nightseas/pi_mods/software/ica_test_codes/README.md

# Test codes for ICA HAT

By Xiaohai Li (haixiaolee@gmail.com)

To run these codes you need to install two hardware libs on Pi:

 - wiringPi-Python2 (which may be merged to wiringPi-Python now);
 - pigpio (only use the python part)
