nightseas/pi_mods/hardware/pi_mod_ica/PiModICA_R0A_BOM.xlsx

ICA HAT for Raspberry Pi Revised: Tuesday, May 19, 2015
ICA Revision: R0A
Item | Part | PCB FP | Quantity | Reference
1 | 0.1uF NC | C0603 | 1 | C1
2 | 0.1uF | C0603 | 1 | C2
3 | 10uF | C0805 | 1 | C3
4 | LED_IR | SIP2 | 1 | D1
5 | LED_IR NC | SIP2 | 1 | D2
6 | RPI CON | SIP20X2 | 1 | J1
7 | EXT IO | SIP4 | 1 | J2
8 | EXT IIC | SIP4 | 1 | J3
9 | EXT UART | SIP4 | 1 | J4
10 | EXT SPI | SIP7 | 1 | J5
11 | EXT PWR | SIP4 | 1 | J6
12 | GRN | LED0805 | 4 | LD1,LD2,LD3,LD4
13 | LED_SEG7_X4_DP | LED_SEG7_X4_DP_036 | 2 | LD5,LD6
14 | RED | LED0805 | 1 | LD7
15 | 2N7002_NMOS | SOT23 | 3 | Q1,Q2,Q3
16 | 9013 | SOT23 | 2 | Q4,Q5
17 | 10K NC | R0603 | 2 | R1,R39
18 | 10K | R0603 | 14 | R2,R3,R4,R5,R6,R7,R8,R9,R10,R11,R16,R17,R31,R35
19 | 100R | R0603 | 11 | R12,R13,R20,R21,R23,R24,R27,R28,R29,R30,R32
20 | 510R | R0603 | 6 | R14,R15,R18,R19,R22,R33
21 | 120R | R0603 | 1 | R25
22 | 120R NC | R0603 | 1 | R26
23 | 1K | R0603 | 1 | R34
24 | 0R NC | R0603 | 3 | R36,R37,R38
25 | USER_KEY | SW_6X6_180D | 5 | SW1,SW2,SW3,SW4,SW5
26 | TH2_5 | TH2_5 | 4 | TH1,TH2,TH3,TH4
27 | AT24C02 NC | SO8 | 1 | U1
28 | MAX7219CWG | WSO24 | 1 | U2
29 | BUZZER | BUZZER_12X9_5 | 1 | U3
30 | HS0038 | IR_RECV | 1 | U4
