nightseas/pi_mods/hardware/pi_mod_mot/PiMod_MOT_R0A_SCH.pdf

NC unused GPIO pins and the 3.3V power pins. RPi only needs 5V external supply.

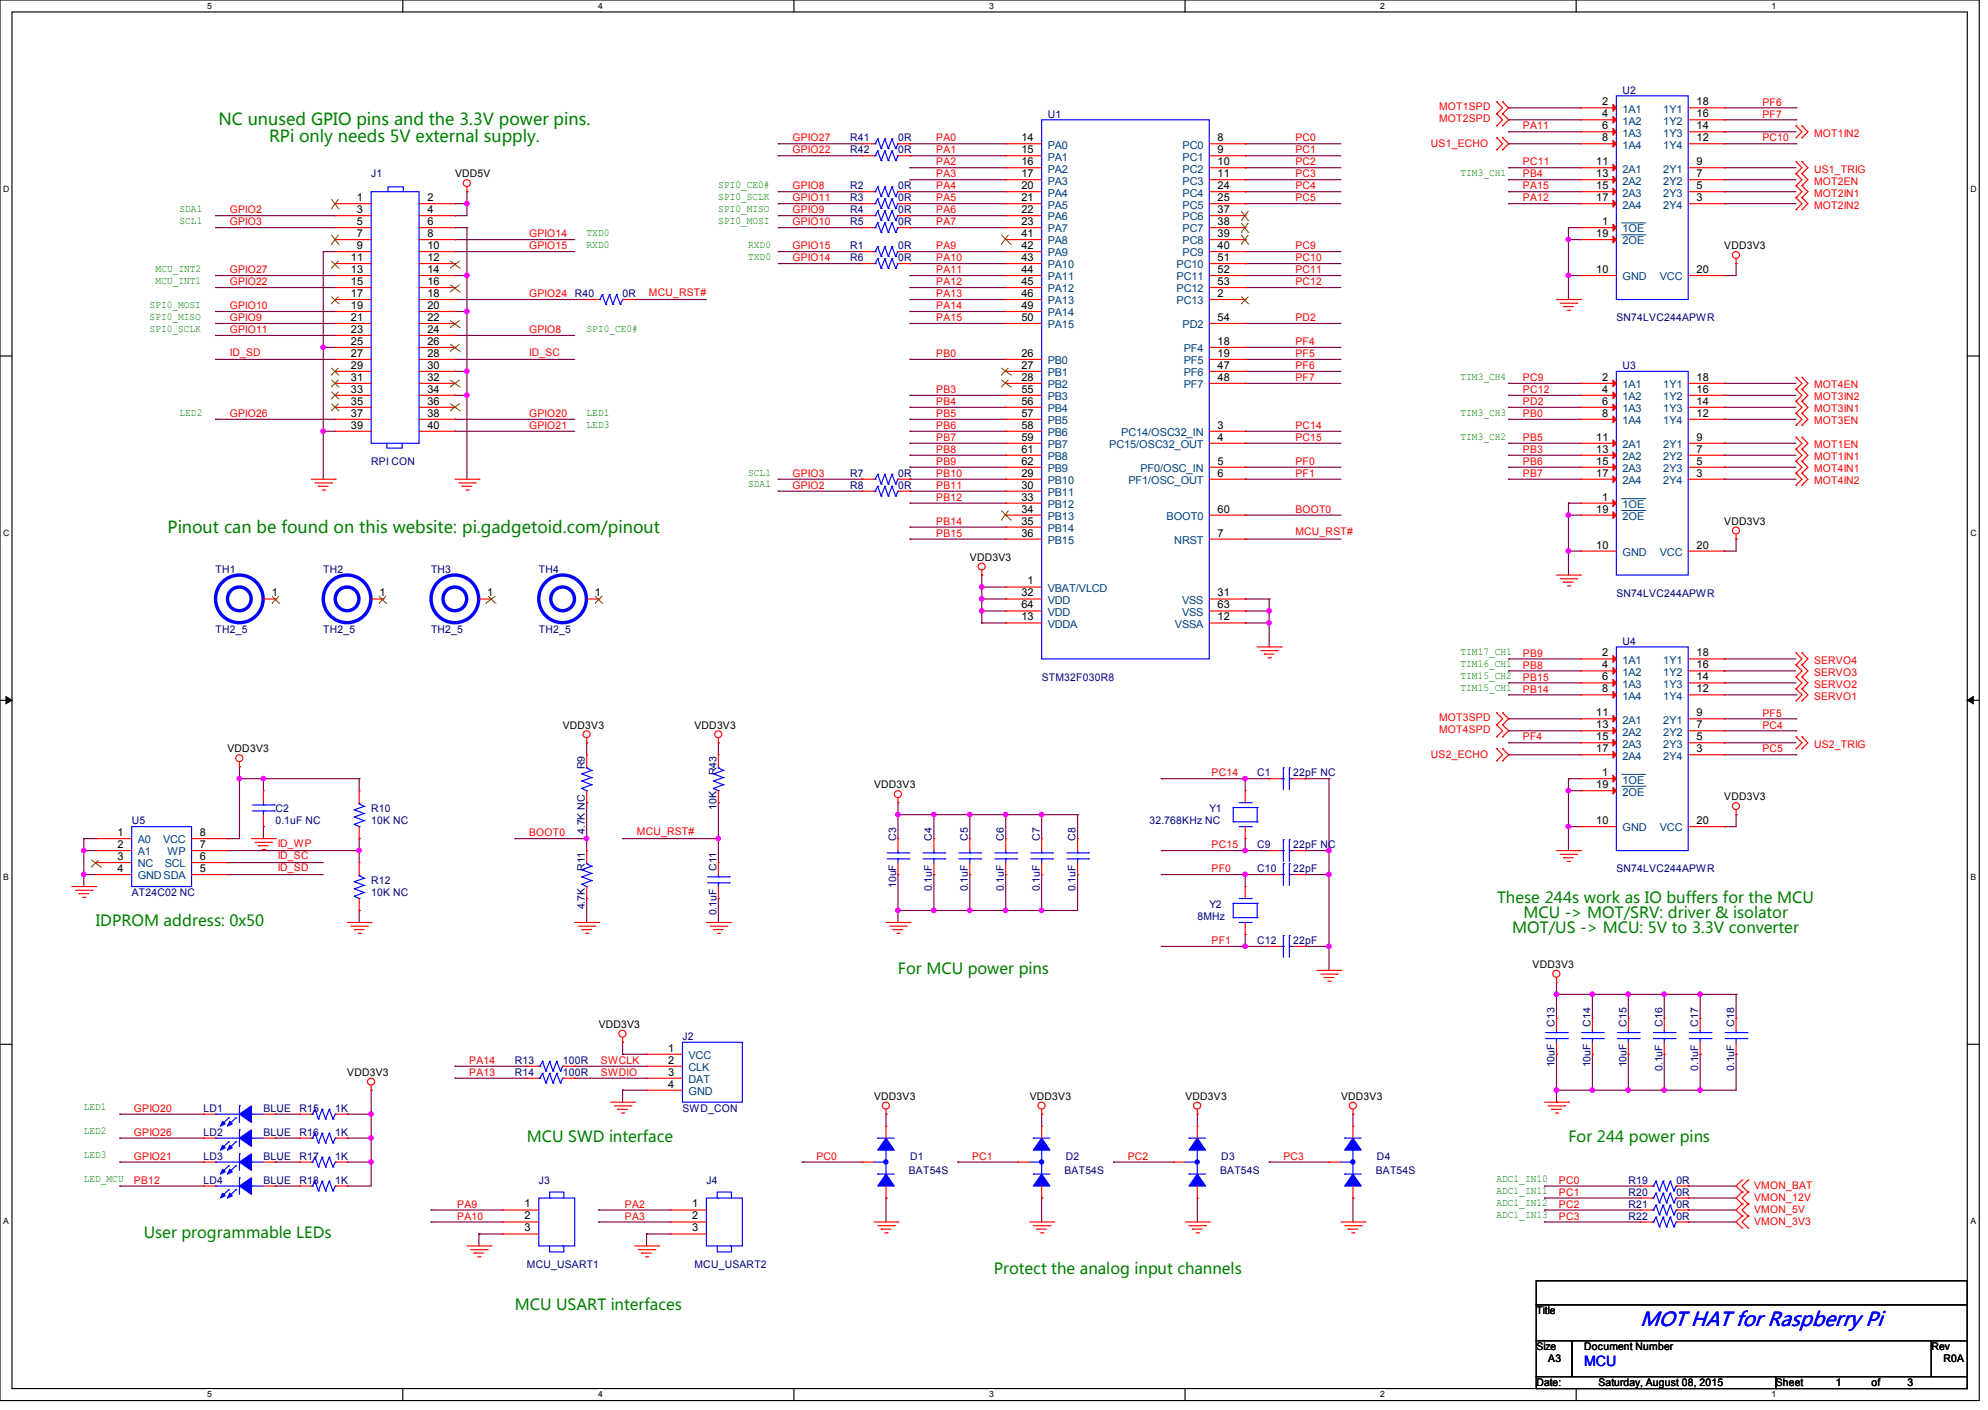
[picture p1: page 1]

Pinout can be found on this website: pi.gadgetoid.com/pinout

These 244s work as IO buffers for the MCU
MCU -> MOT/SRV: driver & isolator
MOT/US -> MCU: 5V to 3.3V converter

For MCU power pins

Protect the analog input channels

MOT HAT for Raspberry Pi

## [DC Geared Motor] Voltage: 3~6V

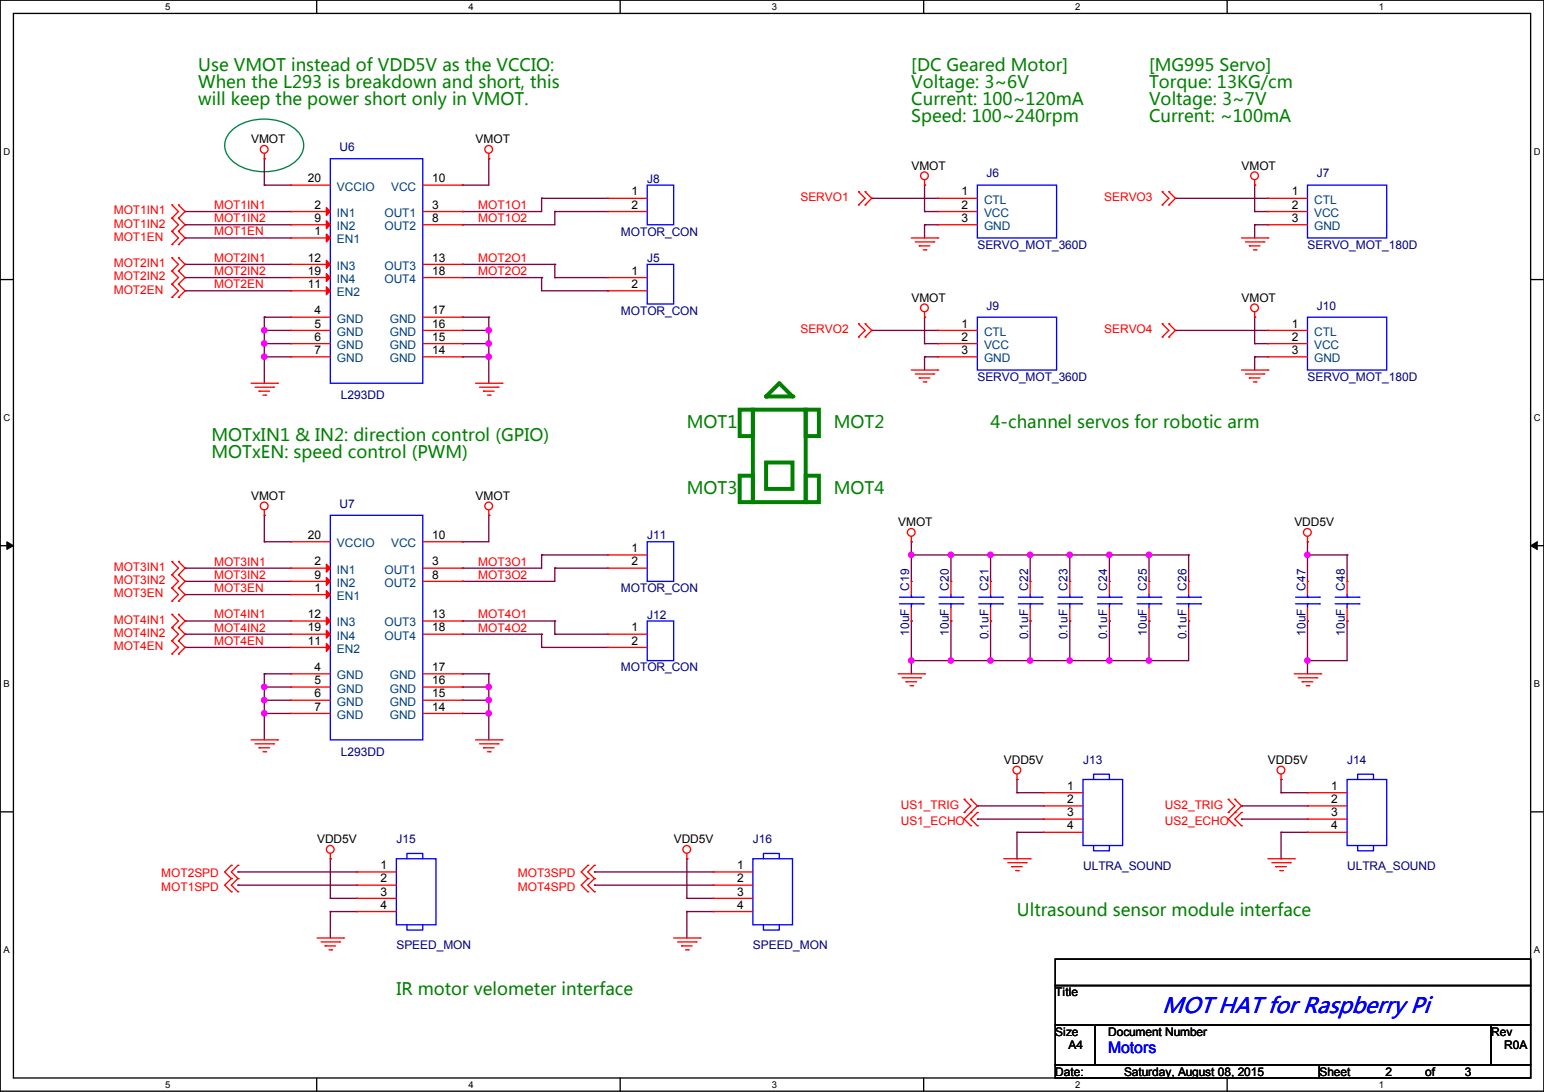
[picture p2: page 2]

Use VMOT instead of VDD5V as the VCCIO:
When the L293 is breakdown and short, this
will keep the power short only in VMOT.

4-channel servos for robotic arm

MOTxIN1 & IN2: direction control (GPIO)
MOTxEN: speed control (PWM)

Ultrasound sensor module interface

IR motor velometer interface

RA

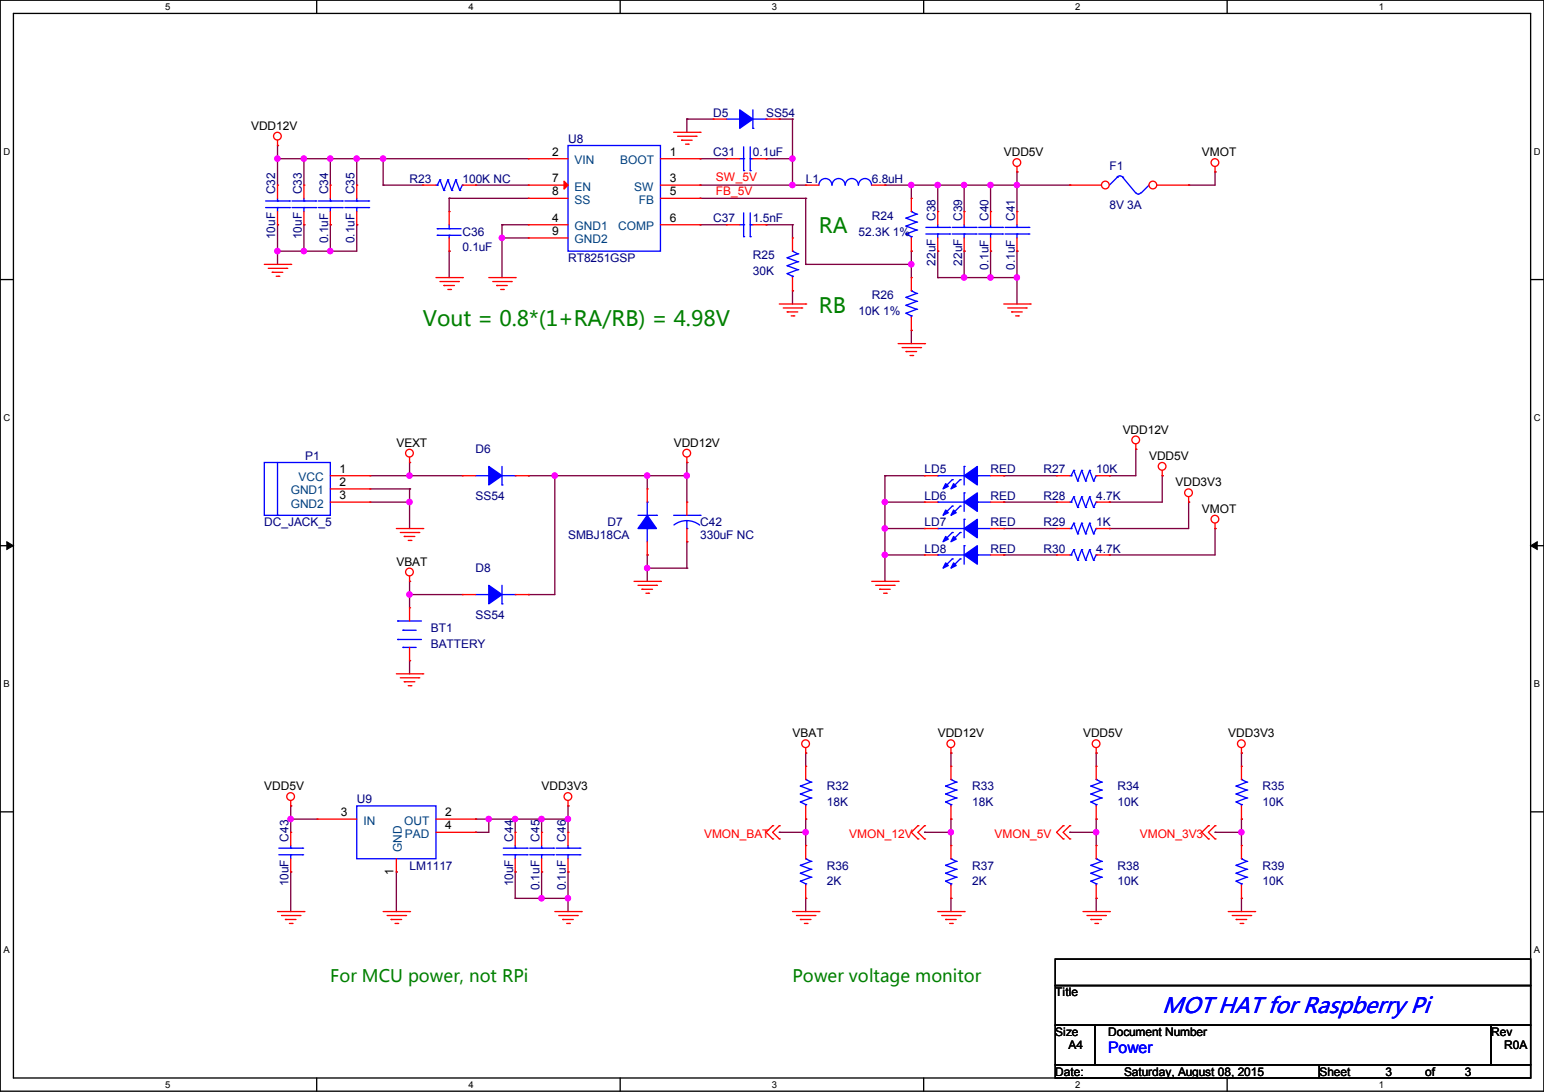
[picture p3: page 3]

RB Vout = 0.8*(1+RA/RB) = 4.98V
