nightseas/pi_mods/hardware/pi_mod_ica/PiMod_ICA_R0A_SCH.pdf

## Segmental LEDs & Serial Driver

## NC PIN1(3.3V) for better layout

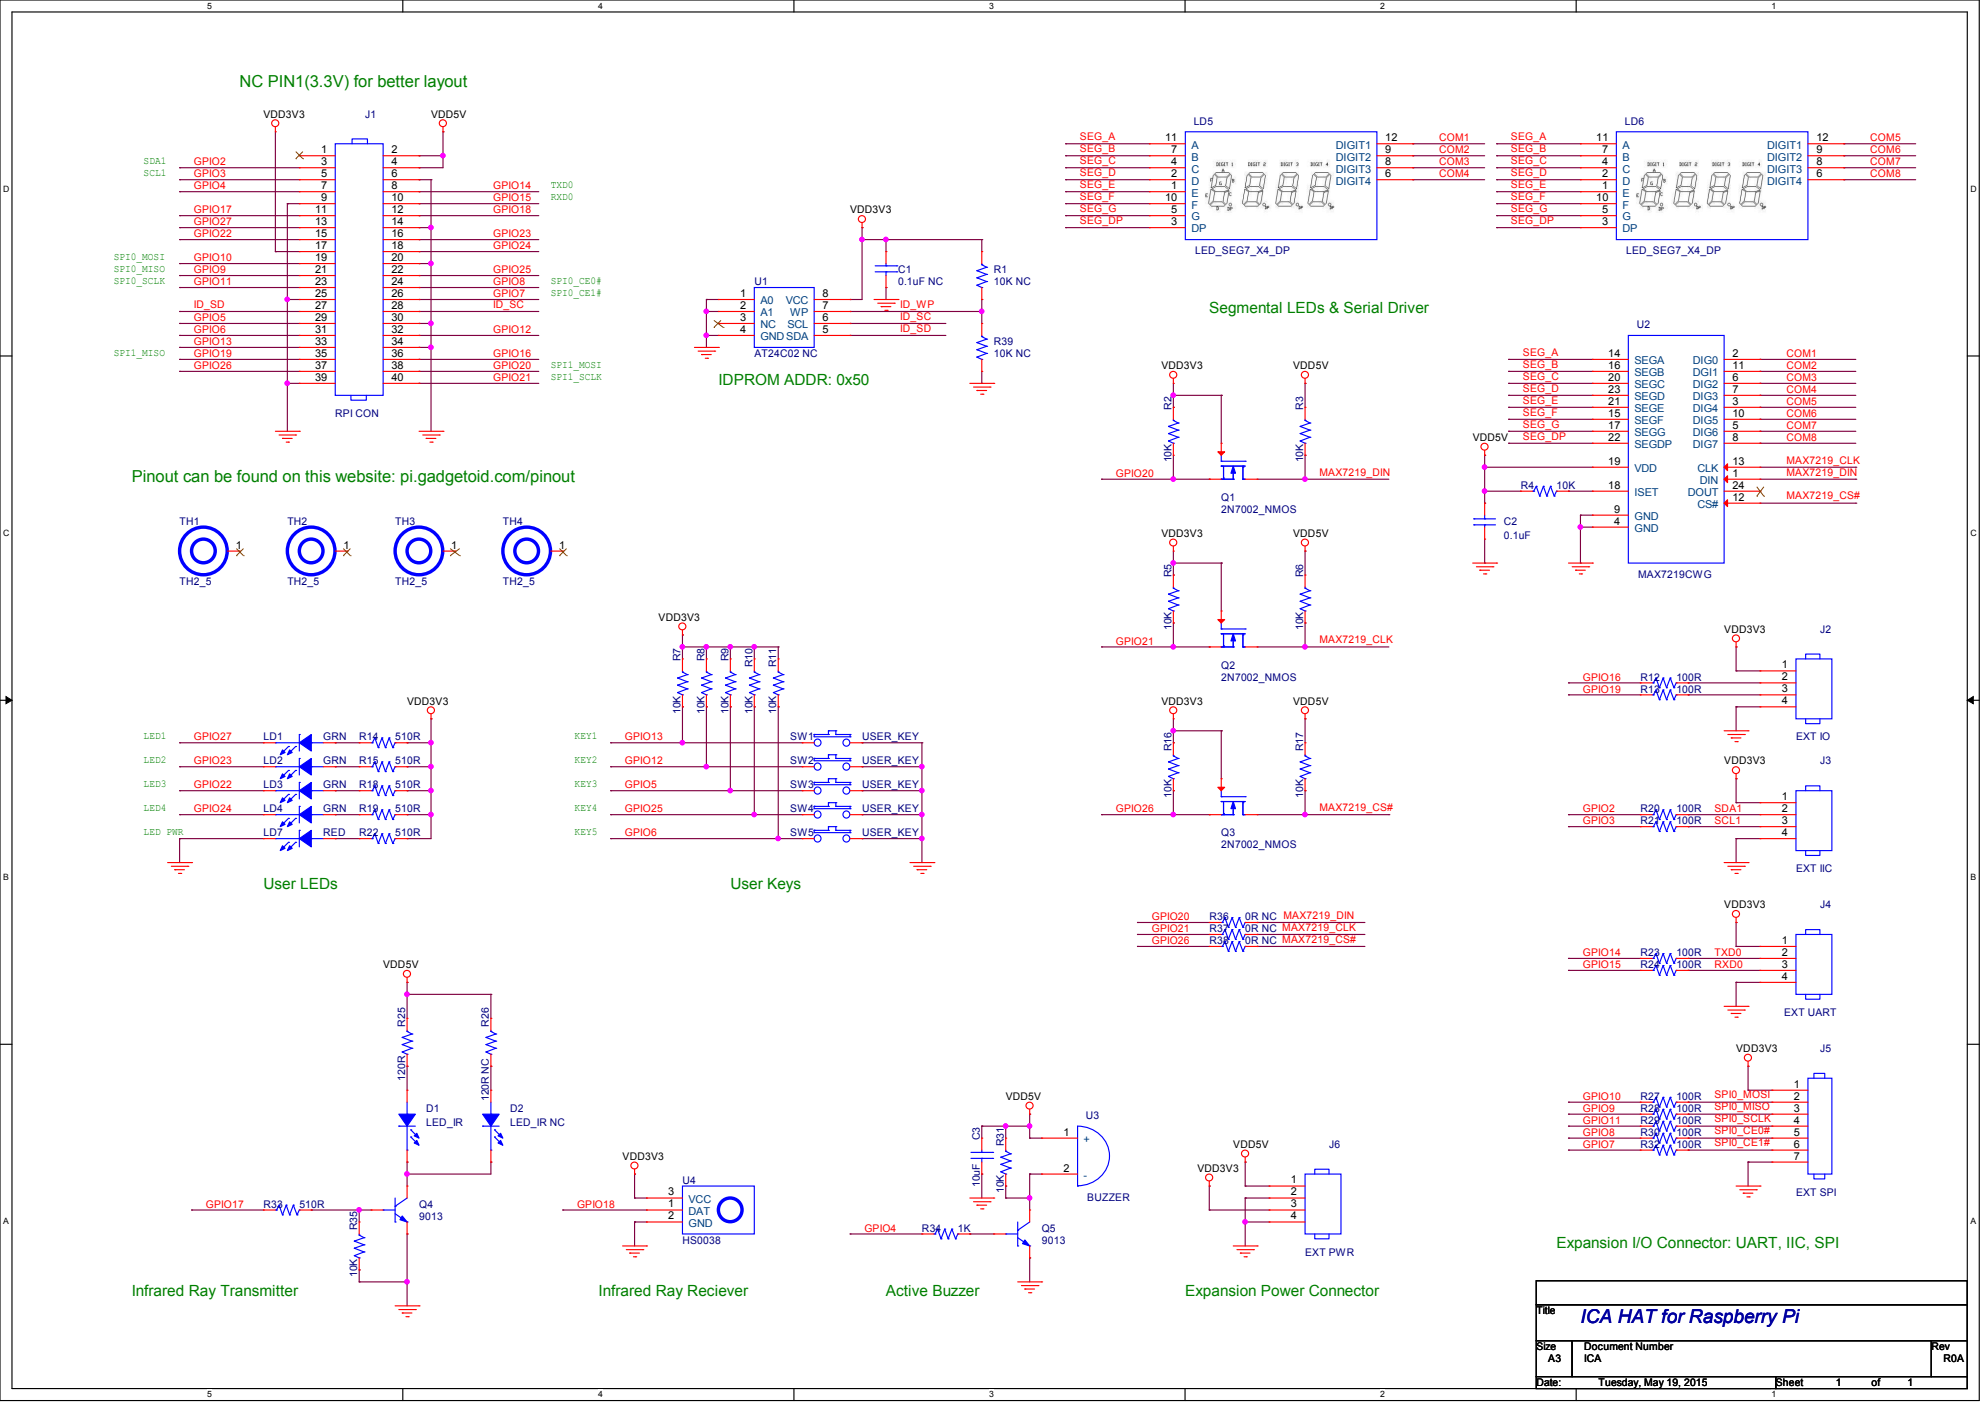
[picture p4: page 1]

Pinout can be found on this website: pi.gadgetoid.com/pinout

Expansion I/O Connector: UART, IIC, SPI

Title
ICA HAT for Raspberry Pi
