nightseas/pi_mods/hardware/pi_mod_ica/PiMod_ICA_R0A_AssemblyBottom.pdf

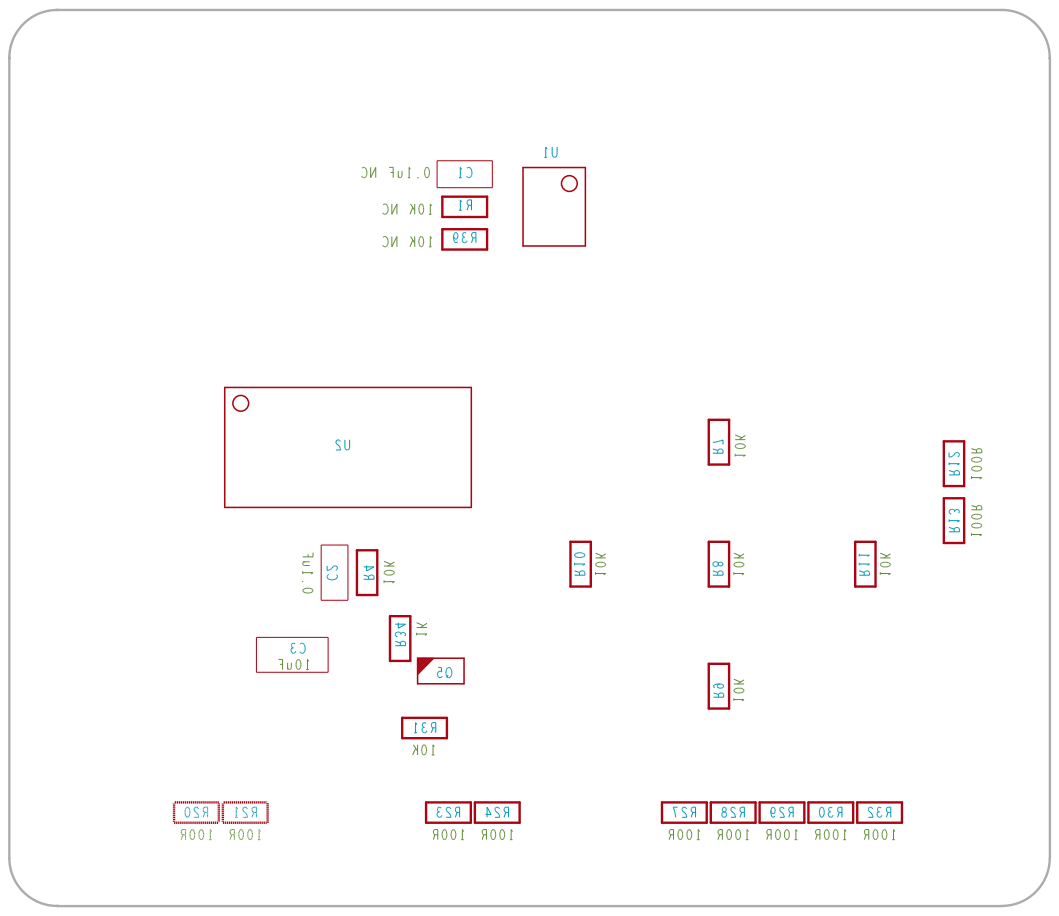
[picture p5: page 1]
