nightseas/pi_mods/hardware/pi_mod_ica/PiMod_ICA_R0A_AssemblyTop.pdf

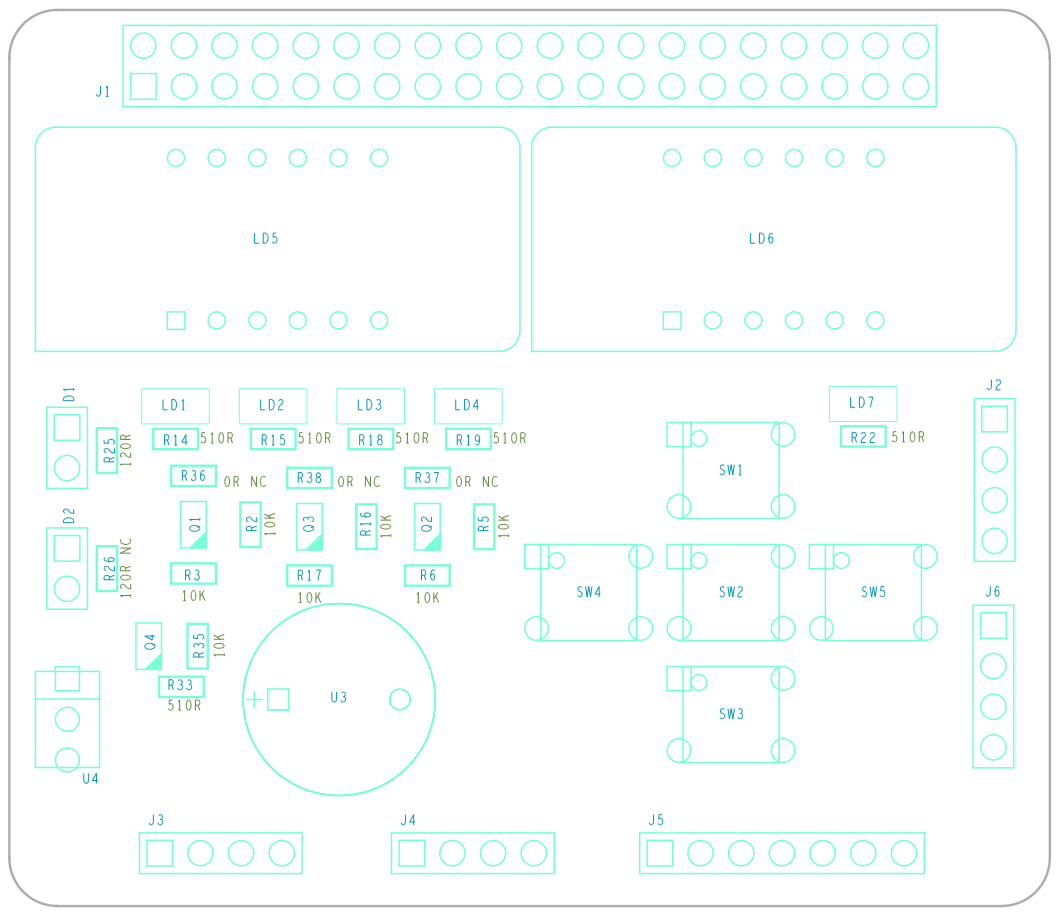
[picture p6: page 1]
