nightseas/pi_mods/hardware/pi_mod_ica/PiMod_ICA_R0A_PCB.pdf

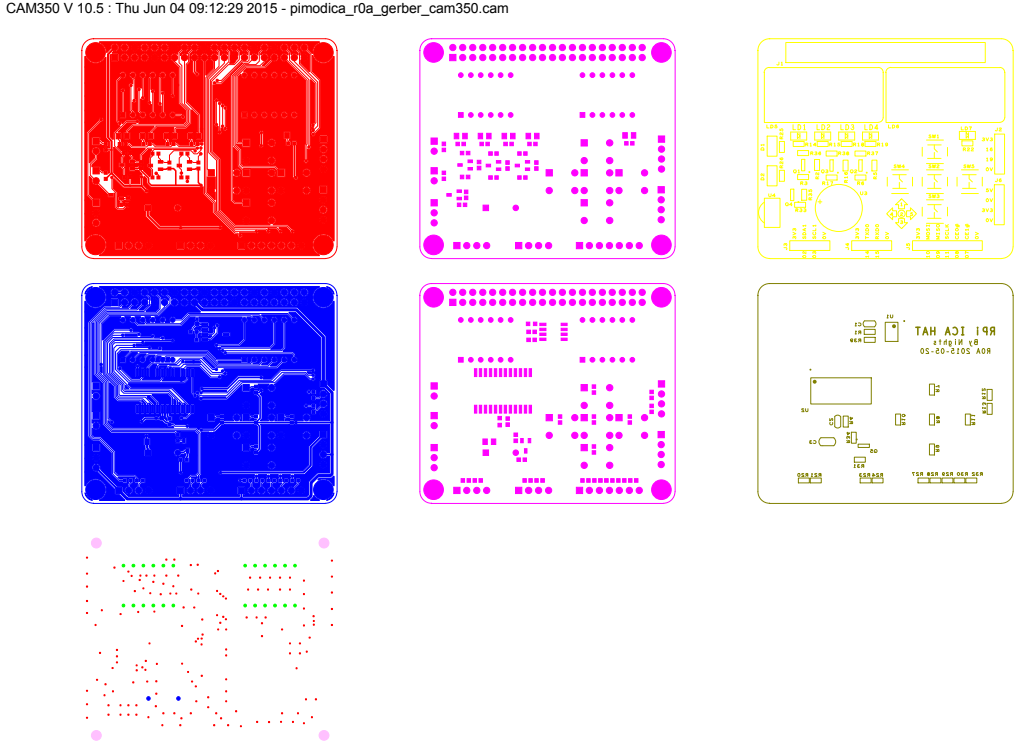
[picture p7: page 1]

CAM350 V 10.5 : Thu Jun 04 09:12:29 2015 - pimodica_r0a_gerber_cam350.cam
