nightseas/pi_mods/(list of files, drawings)

Other design files:
hardware/pi_mod_ica/PiMod_ICA_R0A.DSN
hardware/pi_mod_mot/PiMod_MOT_R0A.DSN
hardware/pi_mod_proto/PiModProto_R0A.DSN
