nightseas/pi_mods/software/ica_test_codes/font_en_8x8.py

# font_en_8x8.py
# Display charactors library for 8x8 LED matrix, just for test.

data = [\
[0x00,0x00,0x00,0x00,0x00,0x00,0x00,0x00],\
[0x00,0x00,0x5F,0x00,0x00,0x00,0x00,0x00],\
[0x00,0x0A,0x06,0x00,0x00,0x0A,0x06,0x00],\
[0x00,0x20,0x74,0x2E,0x74,0x2E,0x04,0x00],\
[0x00,0x24,0x2A,0x7F,0x2A,0x12,0x00,0x00],\
[0x00,0x4E,0x2A,0x1E,0x78,0x54,0x72,0x00],\
[0x00,0x70,0x8E,0xB9,0x56,0xB0,0x80,0x00],\
[0x00,0x00,0x00,0x02,0x00,0x00,0x00,0x00],\
[0x00,0x00,0x1C,0x22,0x41,0x00,0x00,0x00],\
[0x00,0x00,0x41,0x22,0x1C,0x00,0x00,0x00],\
[0x00,0x24,0x18,0x7E,0x18,0x24,0x00,0x00],\
[0x00,0x08,0x08,0x3E,0x08,0x08,0x00,0x00],\
[0x00,0x00,0x40,0x58,0x38,0x00,0x00,0x00],\
[0x00,0x08,0x08,0x08,0x08,0x08,0x08,0x00],\
[0x00,0x60,0x60,0x00,0x00,0x00,0x00,0x00],\
[0x00,0x40,0x20,0x10,0x08,0x04,0x02,0x00],\
[0x00,0x3e,0x51,0x49,0x45,0x3e,0x00,0x00],\
[0x00,0x00,0x42,0x7f,0x40,0x00,0x00,0x00],\
[0x00,0x42,0x61,0x51,0x49,0x46,0x00,0x00],\
[0x00,0x21,0x41,0x45,0x4b,0x31,0x00,0x00],\
[0x00,0x18,0x14,0x12,0x7f,0x10,0x00,0x00],\
[0x00,0x27,0x45,0x45,0x45,0x39,0x00,0x00],\
[0x00,0x3c,0x4a,0x49,0x49,0x30,0x00,0x00],\
[0x00,0x01,0x01,0x79,0x05,0x03,0x00,0x00],\
[0x00,0x36,0x49,0x49,0x49,0x36,0x00,0x00],\
[0x00,0x06,0x49,0x49,0x29,0x1e,0x00,0x00],\
[0x00,0x00,0x66,0x66,0x00,0x00,0x00,0x00],\
[0x00,0x00,0x40,0x32,0x00,0x00,0x00,0x00],\
[0x00,0x08,0x14,0x22,0x41,0x00,0x00,0x00],\
[0x00,0x24,0x24,0x24,0x24,0x24,0x24,0x00],\
[0x00,0x41,0x22,0x14,0x08,0x00,0x00,0x00],\
[0x00,0x06,0x01,0x51,0x09,0x06,0x00,0x00],\
[0x3C,0x42,0x59,0x55,0x1D,0x22,0x1E,0x00],\
[0x00,0x7E,0x11,0x11,0x11,0x7E,0x00,0x00],\
[0x00,0x7F,0x49,0x49,0x49,0x36,0x00,0x00],\
[0x00,0x1C,0x22,0x41,0x41,0x41,0x00,0x00],\
[0x00,0x7F,0x41,0x41,0x22,0x1C,0x00,0x00],\
[0x00,0x7F,0x49,0x49,0x49,0x41,0x00,0x00],\
[0x00,0x7F,0x09,0x09,0x09,0x01,0x00,0x00],\
[0x00,0x1C,0x22,0x41,0x49,0x39,0x08,0x00],\
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
