nightseas/pi_mods/(commit log)

2015-06-29 Create ICA HAT for RPi
    [PiModICA_R0A_BOM.xlsx, PiMod_ICA_R0A.DSN, PiMod_ICA_R0A.brd]
2015-07-27 Create Motor HAT
    [PiMod_MOT_R0A.DSN]
2015-07-28 Update Motor HAT PCB
    [PiMod_MOT_R0A v0.1.brd, PiMod_MOT_R0A v0.2.DSN, PiMod_MOT_R0A.DSN]
2015-07-29 Performing PCB Placement
    Adjust some SCH signals & capacitors
    [PiMod_MOT_R0A V0.2.brd, PiMod_MOT_R0A v0.1.brd, PiMod_MOT_R0A v0.2.DSN, PiMod_MOT_R0A v0.3.DSN]
2015-07-29 Uncompress some packages
    [PiModProtoFull_R0A.brd, PiModProtoMini_R0A.brd, PiModProto_R0A.DSN]
2015-08-05 Update layout and adjust SCH for PCB routing
    [PiMod_MOT_R0A V0.2.brd, PiMod_MOT_R0A v0.3.DSN, PiMod_MOT_R0A v0.3.brd, PiMod_MOT_R0A v0.4.DSN]
2015-08-05 Update layout, splite power plane
    [PiMod_MOT_R0A v0.3.brd, PiMod_MOT_R0A v0.4.DSN]
2015-08-05 Revert "Update layout, splite power plane"
    This reverts commit 7875157f00fa7a14edbbbe86afefb426ca614195.
    [PiMod_MOT_R0A v0.3.brd, PiMod_MOT_R0A v0.4.DSN]
2015-08-05 Update layout, split power plane
    [PiMod_MOT_R0A v0.3.brd, PiMod_MOT_R0A v0.4.DSN]
2015-08-06 Layout finished. To be reviewed...
    [PiMod_MOT_R0A v0.3.brd, PiMod_MOT_R0A v0.4.DSN, PiMod_MOT_R0A v0.5.DSN, PiMod_MOT_R0A v0.5.brd]
2015-08-08 First round review done! Errors fixed.
    1. Change TIM3_CH4 to PC9 according to mbed definition.
    2. Correct VMOT resistors.
    3. NC pull-up res of BOOT0. BOOT0=0 will boot from flash.
    4. Correct STM32 PF pins from power to passive.
    5. Change J15 speed signals to fit the motor positions.
    [PiMod_MOT_R0A v0.5.DSN, PiMod_MOT_R0A v0.5.brd, PiMod_MOT_R0A.DSN, PiMod_MOT_R0A.brd]
